FranciscooGarciaa/Robert-v2/cad/README.md

# Robert V2: piezas para imprimir

`RobertV2.3mf` es el proyecto de Bambu Studio tal cual: **16 placas**, cada pieza ya colocada y
orientada, y los cortes con sus conectores. Ábrelo en **Bambu Studio** u **OrcaSlicer** y verás
las placas exactamente así. En otros laminadores (PrusaSlicer, Cura...) se abre la geometría,
pero no la distribución por placas.

Está preparado para una **Bambu Lab A1 mini** (cama de 180 × 180 mm, boquilla de 0,4 mm,
perfil "0.20mm Standard") con **PLA**. Las piezas grandes van cortadas en dos (A y B) para que
quepan en esa cama; en una impresora más grande también se pueden imprimir así.

| Placas | Pieza | Cantidad |
|---|---|---|
| 1-4 | Neumático | 4 |
| 5-8 | Llanta | 4 |
| 9-10 | Base (B y A) | 1, en dos mitades con conectores |
| 11-12 | Capa 2 (B y A) | 1, en dos mitades con conectores |
| 13 | Pletina lateral ×4 y pletina izquierda ×4 | 8 |
| 14 | Soporte de motor | 3 |
| 15-16 | Tapa (B y A) | 1, en dos mitades con conectores |

Las mitades A llevan los huecos y las B los pivotes: se encajan y se pegan.

## Licencia

Las piezas están bajo [CC BY-NC 4.0](LICENSE.md): puedes imprimirlas, modificarlas y
compartirlas citando el proyecto, pero **no con fines comerciales**. El código del repositorio
tiene su propia licencia no comercial ([PolyForm Noncommercial](../LICENSE.md)).
