FranciscooGarciaa/Robert-v2/pi/requirements-voice.txt

# Voice and vision services (robert.voice, robert.vision), on the Pi only. openwakeword pins tflite-runtime,
# which has no Python 3.13 aarch64 wheel; it runs on onnxruntime instead:
#   pip install -r requirements-voice.txt && pip install --no-deps openwakeword
google-genai>=1.40
webrtcvad-wheels>=2.0.14
piper-tts>=1.3
onnxruntime>=1.20
scikit-learn>=1.5
scipy>=1.13
tqdm>=4.66
requests>=2.32
pillow>=10
