FranciscooGarciaa/Robert-v2/cad/RobertV2.3mf

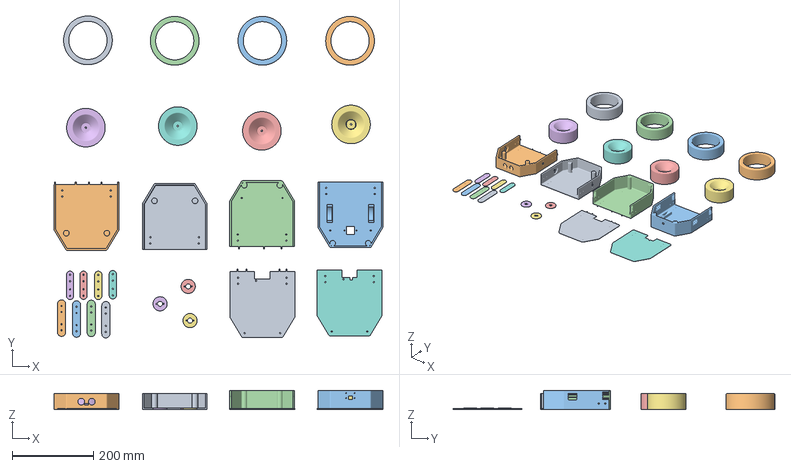
[picture p1: CAD file, 2026-10-29]
cad/RobertV2.3mf
810.0 x 793.3 x 48.0 mm
Neumatico (1) x 4
LLanta (1) x 4
Base_A
Base_B
Capa 2_A
Capa 2_B
Pletina Lateral x 4
Pletina Izquierda x 4
Soporte motor x 3
Tapa_A
Tapa_B
