FranciscooGarciaa/Robert-v2/(commit log)

2026-10-22 Robert V2 milestone 1: ESP32 motor/safety firmware, Pi backend, PWA
2026-10-22 Fix ESP32 watchdog wraparound; add OTA updates; tidy backend logs and deploy
2026-10-22 Read the D6 LiDAR on the Pi and show it as a radar in the PWA
    Background thread decodes the COIN-D6 serial protocol (checksummed,
    resyncing), bins each revolution into 360 robot-frame sectors and
    publishes it in the state; the PWA draws it. Deploy script accepts SSH
    options for when robert.local does not resolve.
2026-10-22 Add ROS 2 LaserScan bridge node and a LiDAR/ROS guide
2026-10-22 Collision guard and reactive Explore mode on the LiDAR
    Every motion command now goes through a swept-footprint guard that slows
    and stops only the dangerous direction; autonomy (Explore) runs at the
    scan rate while the PWA keeps it armed and stops on STOP, manual drive,
    disconnect, blind LiDAR or no progress. Planner scores a fan of arcs;
    ~7 ms per tick on the Pi 4. Adds calibration and scan-recording tools,
    PWA overlays and tests (incl. replay of real scans).
2026-10-22 Use the measured robot footprint (325 x 160 mm, LiDAR centred)
2026-10-23 Add the voice service: wake word, Gemini understanding and speech
    robert-voice runs as its own process: openWakeWord + webrtcvad on the
    ReSpeaker (via arecord), Gemini hears the audio directly and answers in
    structured JSON, Gemini TTS speaks with Piper as the offline fallback.
    Spoken commands go to local-only backend endpoints that run 1 s nudges
    through the dead-man, collision guard and ESP32; voice cannot start
    autonomy. PWA shows what Robert heard and said.
2026-10-23 Voice: stream conversations through Gemini Live for sub-second replies
    After the local wake word, one Live session streams the mic to
    gemini-3.8-live (server VAD, 300 ms end of speech) and plays the reply
    audio chunk by chunk through a persistent aplay. Actions are function
    calls (parar, mover, estado_robot, despedirse) to the existing local-only
    backend endpoints. Half-duplex: mic muted while Robert speaks. Robot
    state now uses the guard's clearances (the raw LiDAR nearest return was
    the robot itself). Piper only renders cached fallback phrases.
    Measured on the Pi: 0.6-0.8 s from end of speech to first reply audio
    (was 3.5-5 s).
2026-10-23 Voice: close the speaker stream when idle; ignore the bare wake word
    An always-open aplay kept the codec DAC on and the amplifier hissed.
    Clearances are now refreshed every nav tick (not only while driving),
    so Robert can tell what is around even with the motors off.
2026-10-24 Add a one-shot Pi setup script (boot config, venv, services, audio levels)
    Third full reinstall in two days: everything a fresh Raspberry Pi OS needs
    for Robert is now one command. Journald goes to RAM to cut SD writes.
2026-10-24 Explore: LiDAR self-mask and frame calibration, back out of dead ends
    - calibrate_lidar.py: mask what the robot hides from its own LiDAR (3 scans,
    robot moved between them), then fix front offset and mirroring with a box;
    mask stored in sensor angles so later frame fixes keep it valid.
    - Guard: autonomy never drives into a masked (blind) sector; manual is capped.
    - Planner: reverse arcs when nothing forward fits and turning is blocked or
    has not opened a way in ~2.5 s, committed ~0.8 s; 5 cm sampling so tight
    turns predict the corners. AUTO_MAX_SPEED 80 until motion is calibrated.
    - PWA draws blind sectors.
2026-10-24 Record the measured LiDAR mounting offset (272 deg) in .env.example
2026-10-24 Record measured motion constants (0.48 m/s and 65 deg/s at PWM 100)
2026-10-24 Explore back to PWM 100 now that motion is calibrated
2026-10-24 Voice: Robert can look through the front camera
    New 'mirar' tool: a 640x480 still (rpicam-still --immediate, ~0.8 s) goes
    back to Gemini Live attached to the function response, so it describes what
    is actually in front of the robot. Measured on the Pi: photo in hand 1.5 s
    after the question ends.
2026-10-24 Follow me: camera + LiDAR person following, by voice or PWA
    - robert-vision: owns the camera (rpicam-vid YUV, 6 fps), serves instant
    photos to the voice and runs YOLO11n person detection (ONNX, ~170 ms)
    only while following; posts person directions to the backend.
    - nav/follow.py: acquire the nearest person-sized LiDAR cluster the camera
    also sees in front; track it at 10 Hz (alpha-beta, gated), lost after 2 s,
    re-acquired within 4 s, else gone.
    - Follow mode in the autonomy loop: keep 1.2 m, face the person, avoid
    obstacles with the arc planner; the person is the dead-man (lost, >3 m,
    10 min, STOP, manual drive or 'para' end it). Voice tools seguirme /
    dejar_de_seguir; PWA but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
2026-10-24 Vision: send plain floats (numpy scalars broke JSON and killed detection)
    The detect thread died on the first frame with a person in it; it now
    survives a bad frame too.
2026-10-24 Follow: accept narrow leg clusters (a leg at 3 m is only 2-3 LiDAR points)
2026-10-24 setup_pi.sh protect/unprotect: read-only SD overlay against power cuts
    Two SD cards were lost to supply cut-outs during boot.
2026-10-24 Audio output at 0 dB now that the PAM runs from the LiPo
2026-10-25 Street day: follow faster, dances, selfies, social greetings, hotspot setup
    - Follow up to PWM 200 (~0.95 m/s) and 4.5 m, gain 1.2.
    - robot/dance.py: short fixed routines through the normal motion path
    (guard, dead-man, ESP32), cancelled by any stop, 6 s max.
    - Selfies: vision pauses its stream for a 2592x1944 still; PWA gallery
    (/api/photos, path-checked); countdown and shutter sounds.
    - Social mode: a person-sized LiDAR cluster within 1.2 m in front for 2 s,
    confirmed by one camera detection, makes Robert greet them without the
    wake word (Live session opened with a text turn); 60 s cooldown, never
    while moving or talking. Toggle in PWA or by voice.
    - voice/sfx.py: synthesised R2-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
2026-10-25 PWA push-to-talk: talk to Robert through the phone's mic
    Held button streams 16 kHz PCM16 over /ws/talk to the voice service, which
    uses it instead of the robot's mic for that conversation (useful when he is
    roaming the street); Robert answers through his speaker. The backend also
    serves HTTPS on 8443 with a local CA (tools/make_certs.sh, kept out of git;
    the CA key never leaves the Mac) because iOS only allows the mic on secure
    pages.
2026-10-25 ESP32: when Wi-Fi fails, log the networks it can see (every 5th attempt)
2026-10-28 Memory: a diary per session and a summary Robert carries across sessions
    pi/robert/memory.py writes one JSONL event per thing that happens (voice turns,
    spoken commands, photos, notes, greetings, and the transitions it observes on
    the RobotState: ESP32 lost, safety stops, follow start/end with the reason,
    explore, stuck, dances) and keeps memory.json with totals, the last sessions,
    stories told in Robert's own voice, notes people asked him to keep and his
    recent conversations. The voice gets a short Spanish recall in every prompt and
    two tools: recordar and apuntar. pi/memory_seed.json seeds the first stories
    (the street day). pi/scripts/pull_memory.sh copies the memory off the Pi, which
    kee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
2026-10-29 Ready to clone: pick the voice's AI (Gemini or OpenAI) and keep personal values out of git
    The voice talks to a provider adapter (pi/robert/voice/providers/): gemini wraps the
    existing Gemini Live session, openai is new and drives OpenAI Realtime over a plain
    WebSocket (mic resampled to 24 kHz, the camera photo sent as an image item after the
    function result). pi/.env takes AI_PROVIDER, AI_API_KEY, AI_MODEL, AI_VOICE; an old
    GEMINI_API_KEY still works. OWNER_NAME replaces the hard-coded name in the prompt.
    Personal values moved to git-ignored files: the systemd units get the user and home
    at install time, the scripts read PI/SSH_OPTS/HOTSPOT from pi/scripts/local.env,
    make_certs.sh takes CE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
2026-10-29 CAD: Bambu Studio project with the 16 plates, under CC BY-NC 4.0
2026-10-29 Guía de montaje eléctrico: alimentación, pinout, audio, LiDAR y failsafe
2026-10-29 Guía de montaje: lista de componentes con cantidades y herramientas, y primer encendido con smoke stopper
